Vivek-Neel/ChromaSense/python-gui/cie_background.jpg

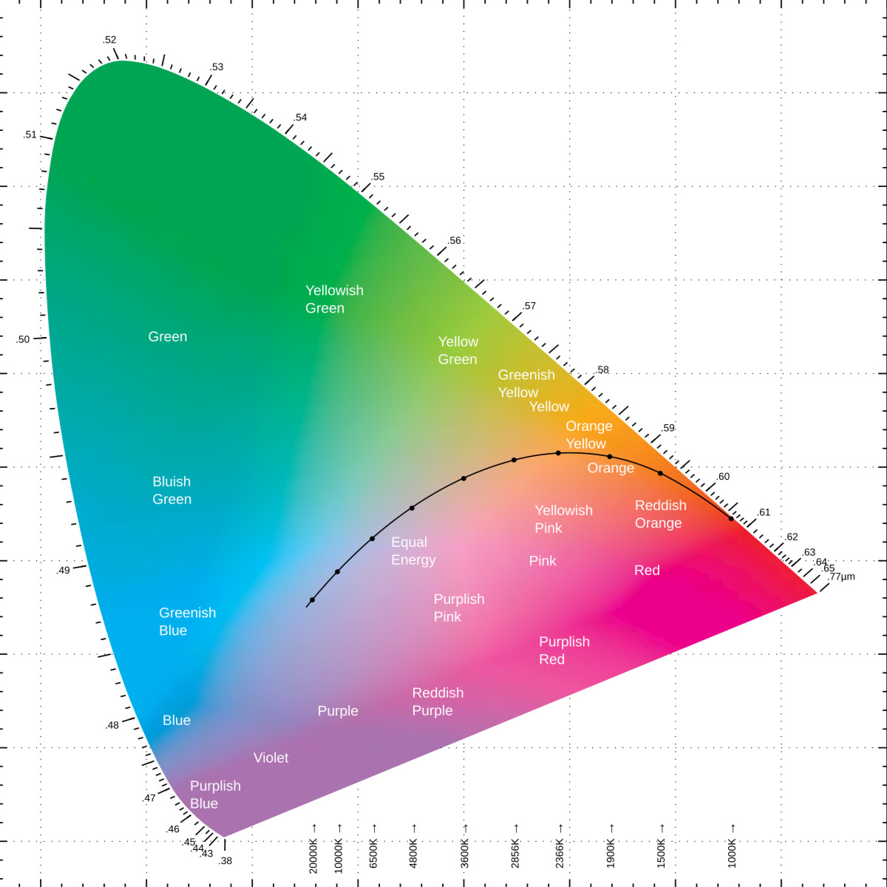
python-gui/cie_background.jpg
