Vivek-Neel/ChromaSense/BOM/ChromaSense_BOM_v2.xlsx

ChromaSense — Bill of Materials
Project: Remote Color Sensor | OTH Regensburg — Faculty ANK | Supervisor: Prof. Johannes Wild
# | Component / Item | Part Number | Qty | Unit Price (€) | Total (€) | Supplier | Order Link 1 | Order Link 2 | Order Link 3
1 | Ams Osram TCS35303-2M XYZ Tristimulus Ambient Light Sensor IC | TCS35303-2M | 3 | 8.50 € |  | Mouser / Digi-Key / Farnell | https://eu.mouser.com/ProductDetail/ams-OSRAM/TCS35303-2M?qs=mELouGlnn3fDaav70DI0sw%3D%3D | https://ams-osram.com/de/products/sensor-solutions/ambient-light-color-spectral-proximity-sensors/ams-tcs3530-true-color-sensor-with-flicker-detection | https://de.farnell.com/en-DE/ams-osram-group/tcs35303-2m/colour-sensor-1-7-to-1-98v-olga/dp/4332688
2 | AP2112K-1.8TRG1 1.8 V LDO Voltage Regulator (SOT-23-5) | AP2112K-1.8TRG1 | 2 | 0.45 € |  | Mouser / Digi-Key / Farnell | https://eu.mouser.com/ProductDetail/Diodes-Incorporated/AP2112K-1.8TRG1?qs=x6A8l6qLYDBx1xhw8AX2cw%3D%3D | https://www.digikey.de/de/products/detail/diodes-incorporated/AP2112K-1-8TRG1/4470745 | https://de.farnell.com/diodes-inc/ap2112k-1-8trg1/ldo-festsp-regl-1-8v-0-6a-40-bis/dp/3482764
3 | MLCC 4.7 µF / 10 V / X5R / 0402 Decoupling capacitor | GRM155R61A475ME15D | 10 | 0.06 € |  | Mouser / Digi-Key / Reichelt | https://eu.mouser.com/ProductDetail/TAIYO-YUDEN/MLASL105BB5475MFNB33?qs=tlsG%2FOw5FFjA1%252BwfadnU2A%3D%3D | https://www.reichelt.de/de/de/shop/produkt/mlcc_0402_4_7uf_10_v_x5r_-20_-411511 | https://de.farnell.com/multicomp-pro/0402x475k100ct/kondensator-4-7uf-10v-mlcc-0402/dp/3764112
4 | MLCC 1 µF / 10 V / X5R / 0402 Decoupling capacitor | GRM155R61A105KE15D | 10 | 0.04 € |  | Mouser / Digi-Key / Reichelt | https://eu.mouser.com/ProductDetail/KYOCERA-AVX/KGM05AR51A105KN?qs=Jm2GQyTW%2FbiJyQ6VgfJuDw%3D%3D | https://www.reichelt.de/de/de/shop/produkt/mlcc_0402_10uf_10_v_x5r_-20_-411507 | https://eu.mouser.com/ProductDetail/KYOCERA-AVX/KGM05AR51A105KN?qs=Jm2GQyTW%2FbiJyQ6VgfJuDw%3D%3D
5 | MLCC 100 nF / 16 V / X7R / 0402 Decoupling capacitor (1.8 V rail) | GRM155R71C104KA88D | 100 | 0.005 € |  | LCSC | https://www.lcsc.com/product-detail/C71629.html
6 | Grove HY2.0-4P Connector I²C interface to M5Stack Core2 | HY2.0-4P (SMD) | 3 | 0.35 € |  | Eckstein / Berrybase / M5Stack | https://eckstein-shop.de/M5Stack-Grove-to-4-Pin-Connector-10pcs-EN | https://www.berrybase.de/m5stack-connector-grove-to-4-pin-10-stueck | https://docs.m5stack.com/en/module/extport_for_core2
7 | M5Stack Core2 ESP32 IoT Development Kit (compute + display + battery platform) | M5Stack Core2 v1.1 | 1 | 50.00 € |  | M5Stack (official) | https://shop.m5stack.com/products/m5stack-core2-esp32-iot-development-kit | https://docs.m5stack.com/en/core/core2
8 | PCB Fabrication — ChromaSense Breakout 2-layer, 25×30 mm, 5 pcs, DRC clean, incl. shipping | JLCPCB 2-layer PCB | 5 | 3.00 € |  | JLCPCB | https://jlcpcb.com/
ESTIMATED TOTAL (excl. shipping)
