Vivek-Neel/ChromaSense/hardware/steps/ChromaSense_Breakout.step

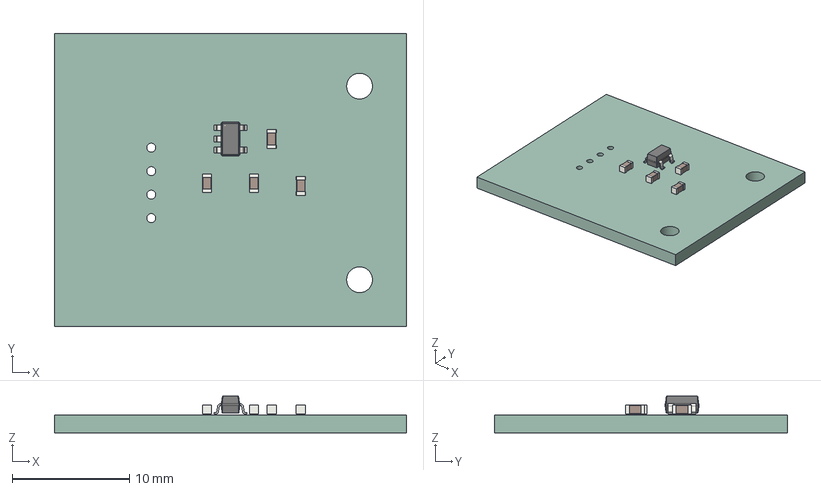
[picture p7: CAD file, 2026-10-16]
hardware/steps/ChromaSense_Breakout.step
30.0 x 25.0 x 3.15 mm
C_0603_1608Metric x 4
SOT-23-5
CromaSense_Breakout_PCB
