Vivek-Neel/ChromaSense/hardware/ChromaSense_Breakout_schematic.pdf

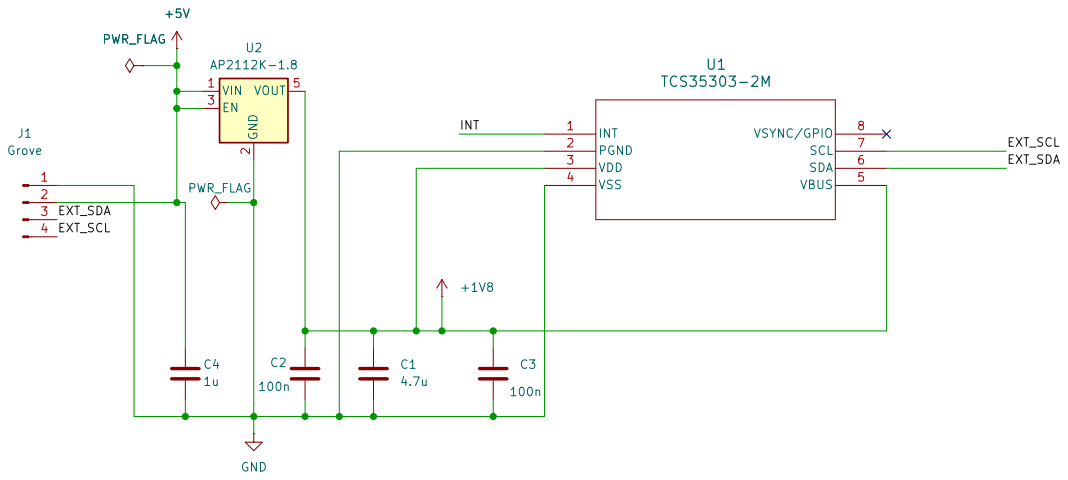
[picture p8: page 1]

Vivek Wilson Neelamkavil Licensed under CERN-OHL-P v2.

Size: A4 | Rev: 1.1
