Vivek-Neel/ChromaSense/hardware/ChromaSense_Breakout.kicad_pcb

## KiCad design hardware/ChromaSense_Breakout.kicad_pcb (2026-10-16)

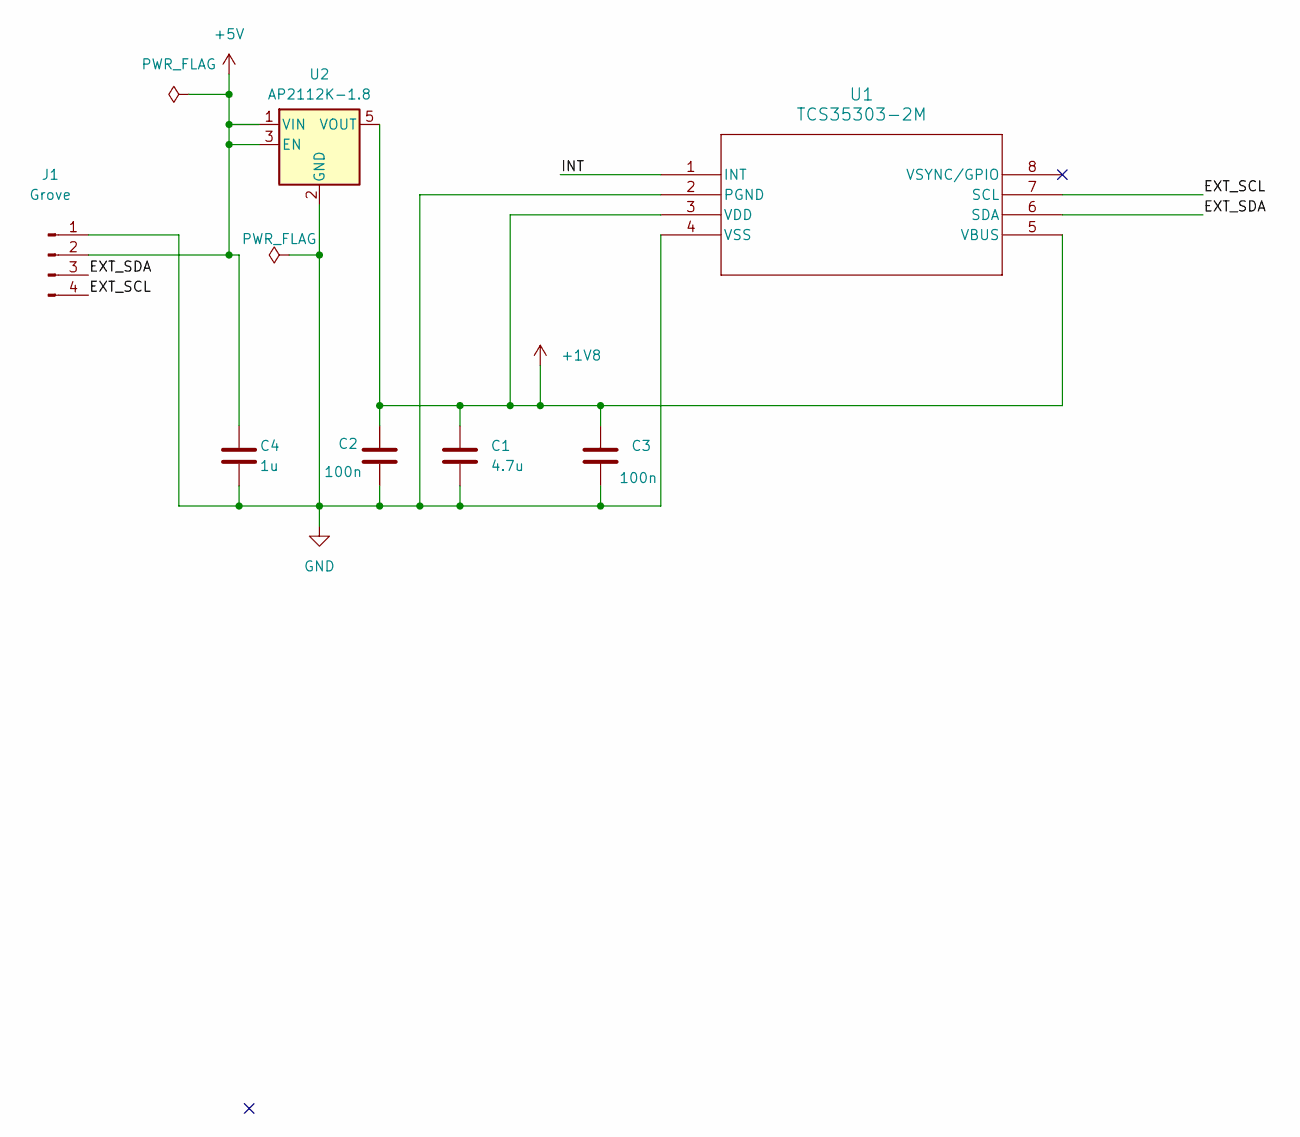
[picture p9: schematic ChromaSense_Breakout.kicad_sch]

Parts:
C1: 4.7u; C_0603_1608Metric
C2, C3: 100n; C_0603_1608Metric
C4: 1u; C_0603_1608Metric
J1: Grove
U1: TCS35303-2M; SMD8_TCS3530_OSM
U2: AP2112K-1.8; SOT-23-5

Connections:
+1V8: C1.2, C2.2, C3.1, U1.3 (VDD), U1.5 (VBUS), U2.5 (VOUT)
+5V: C4.1, J1.2, U2.1 (VIN), U2.3 (EN)
/EXT_SCL: J1.4, U1.7 (SCL)
/EXT_SDA: J1.3, U1.6 (SDA)
/INT: U1.1 (INT)
GND: C1.1, C2.1, C3.2, C4.2, J1.1, U1.2 (PGND), U1.4 (VSS), U2.2 (GND)

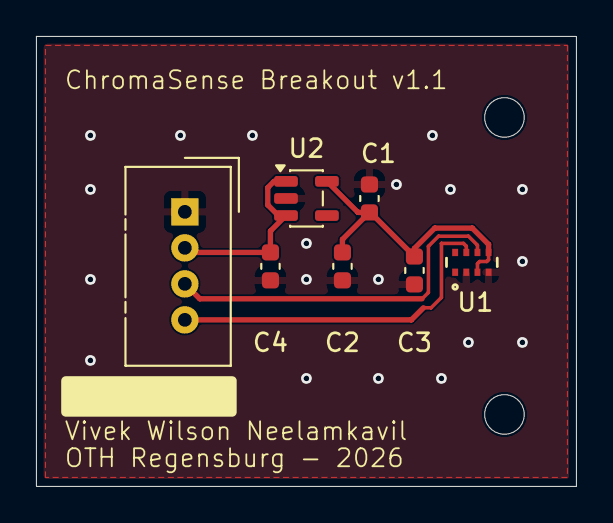
[picture p10: board ChromaSense_Breakout.kicad_pcb from above]

Board: 2 copper layers, 30.0 x 25.0 mm, 7 parts (0 on the bottom side), 5 nets.
