Vivek-Neel/ChromaSense/(commit log)

2026-10-16 Initial commit: ChromaSense — wireless colorimeter
    Custom KiCad breakout PCB for the TCS3530, ESP32 firmware with a
    from-scratch sensor driver and ams-OSRAM factory calibration, and a
    PyQt5 GUI with a CIE 1931 diagram computed from first principles.
2026-10-16 Add BOM, CIE background image, GUI screenshot, PlatformIO placeholders
2026-10-16 BOM: add M5Stack Core2 and JLCPCB fabrication line items; README: link the full BOM
2026-10-16 Match capacitors to the schematic (add 100 nF), add vector schematic PDF, ignore KiCad local files
    Claude-Session: https://claude.ai/code/session_01SnnjAyMwjQGxr5nzvAhxEy
2026-10-16 Schematic PDF: filled title block
    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
2026-10-16 Schematic: fill title block (title, rev 1.1, date, author, licence)
    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
2026-10-23 Schematic PDF: re-plot from public project so the File field reads ChromaSense
    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
